jseyfert3/Indoor-Outdoor_Temp_Sensor/Documentation/Documentation.odt

Indoor-Outdoor Temp Sensor

Documentation, Rev 1.0

## Usage

Indoor sensor

The indoor sensor has a LCD display and three buttons in the front panel of the enclosure. On the right hand side of the enclosure is an opening that allows plugging a microUSB cable in. This will power the indoor sensor. The microcontroller PCB contains a single cell lithium battery charger circuit and JST-PH battery connector. If desired, a single-cell lithium battery may be connected to the PCB. If connected, this will power the microcontroller, sensor, and LCD display if USB is not connected, and will automatically recharge when the USB is connected. The microcontroller code for the indoor sensor has not been optimized for power consumption, so a large battery or a change to the code is suggested if battery operation is desired.

The enclosure is 3D printed with PLA plastic. The rear of the enclosure contains three standard screw mounting holes, for wall hanging with 1 or 2 screws/nails. The bottom of the enclosure contains vent holes next to the temp/humidity sensor. For proper indoor air sensing, the enclosure should not be set on a flat surface.

To use, plug in a microUSB cable connected to a 5 V USB power supply or computer. The device will power up automatically. A red light near the USB connector will light up and begin fading in and out. This indicates the microcontroller is running and is not stuck or frozen. A green LED will be visible near the bottom of the case. This is a power indicator on the SHT45 temp/humidity sensor breakout board, indicating the sensor has power.

Upon power-up, the LCD display will light up and begin displaying data within a few seconds. If an error is detected, an error message will be displayed as the first data screen. These errors include:

- “Unable to initialize SHT45!” – if temp/humidity sensor cannot be communicated with
- “Unable to initialize RTC!” – if the real-time clock cannot be communicated with
- “Unable to initialize SD card!” – if the SD card cannot be communicated with (no SD card, not properly inserted, improperly formatted, etc)

If no errors are detected, the first data screen will be the main display screen of the unit. Indoor data should populate immediately, but outdoor data will not populate until the first transmission from the outdoor unit has been received. Until then, the outdoor data will display as “0.0”

In the upper left corner of the screen is a section titled “Last update:” Below this is “I-” and “O-” followed by a time in 24-hr format. This indicates the times, based on the RTC, at which the indoor and outdoor data was last updated. This is particularly useful for determining if the outdoor sensor has stopped updating, as the outdoor time will stop advancing if no new data is received. It’s typical for the outdoor time to be 1 minute behind the indoor time, as the outdoor unit only sends new data every ~16 seconds, but more than 1 minute indicates a potential failure of the outdoor unit, or interference in the radio transmission or reception.

Configuration and Alternate Displays

From the main display screen, pressing the left button will have the display switch to an alternate sensor. Currently, the display says “Keg” as during coding I had a sensor installed in my kegerator to monitor humidity and temp inside the kegerator. With the addition of another set of hardware similar to the outdoor sensor, an additional sensor can be added to measure the temp/humidity in any desired location, e.g. the basement. Without an additional sensor(s), the screen will just display 0’s. After 10 seconds, the display will revert to the main indoor/outdoor display.

Pressing the right button from the main display screen will display the min/max temp for both indoor and outdoor temps. The min/max time will be since the microcontroller last restarted, either by power cycling or pressing the reset button or updating the firmware. The date/time since last reset is displayed in small text above the min/max temps. After 10 seconds, the display will revert to the main indoor/outdoor display.

Pressing the middle button from the main display screen will open the Configuration Menu. Within the configuration menu, the left key is down, the right key is up, and the middle is select/exit. Use the up and down keys to select a menu option (currently only LCD brightness does anything), and select to enter. Use the up and down keys to adjust the setting and short press select to set and exit back to the top menu. Long press select to exit the Configuration Menu.

Data Logging

Outdoor sensor

The outdoor sensor consists of a 3D printed Stevenson screen and associated mounting brackets. These are printed out of ASA plastic for UV resistance. The base of the screen contains a mounting bracket that holds the microcontroller, temp/humidity sensor, and a battery.

## Hardware Overview

The indoor sensor contains:

- 1.9” Color IPS TFT display (Adafruit 5394)
  - Contains a microSD card slot, which is not used
- Microcontroller, Cortex M0-based with RFM69HCW packet radio, 915 MHz (Adafruit 3176)
  - Spring antenna (Adafruit 4269)
- FeatherWing with PCF8523 RTC & microSD card slot (Adafruit 2922)
  - 8 GB microSD card (Adafruit 1294)
  - CR1220, 3V lithium coin cell for RTC
- Sensirion SHT45 temperature and humidity sensor (Adafruit 5665)
  - JST SH 4-pin to male header cable (Adafruit 4209 or equivalent)
- MicroUSB cable (Adafruit 592)
- 3D printed case

The outdoor sensor contains:

- Microcontroller, Cortex M0-based with RFM69HCW packet radio, 915 MHz (Adafruit 3176)
- Battery, single-cell 2200 mAh lithium with JST-PH connector
- Sensirion SHT45 temperature and humidity sensor (Adafruit 5665)
  - JST SH 4-pin to male header cable (Adafruit 4209 or equivalent)
- 3D printed enclosure
  - Stevenson screen (https://www.thingiverse.com/thing:4153206)
  - Stevenson screen base, custom modification of the one in above link
  - Stevenson screen base mounting bracket
  - Sensor/battery/microcontroller mount
