jseyfert3/Indoor-Outdoor_Temp_Sensor/Documentation/Adafruit/bq24074 schematic.png

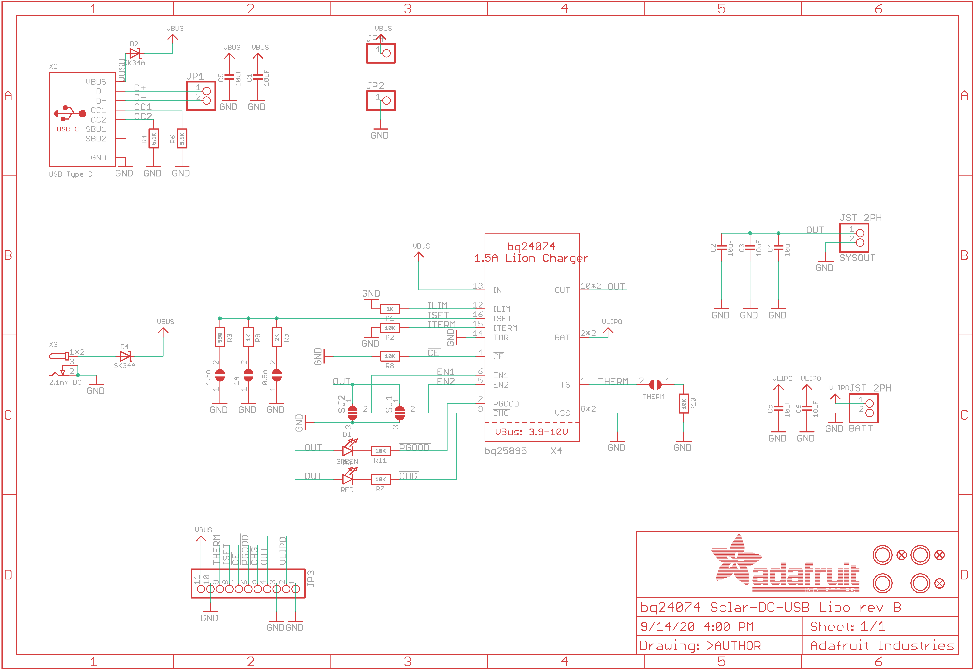
Documentation/Adafruit/bq24074 schematic.png
