jseyfert3/Indoor-Outdoor_Temp_Sensor/Documentation/Adafruit/RFM69 M0 pinout.jpg

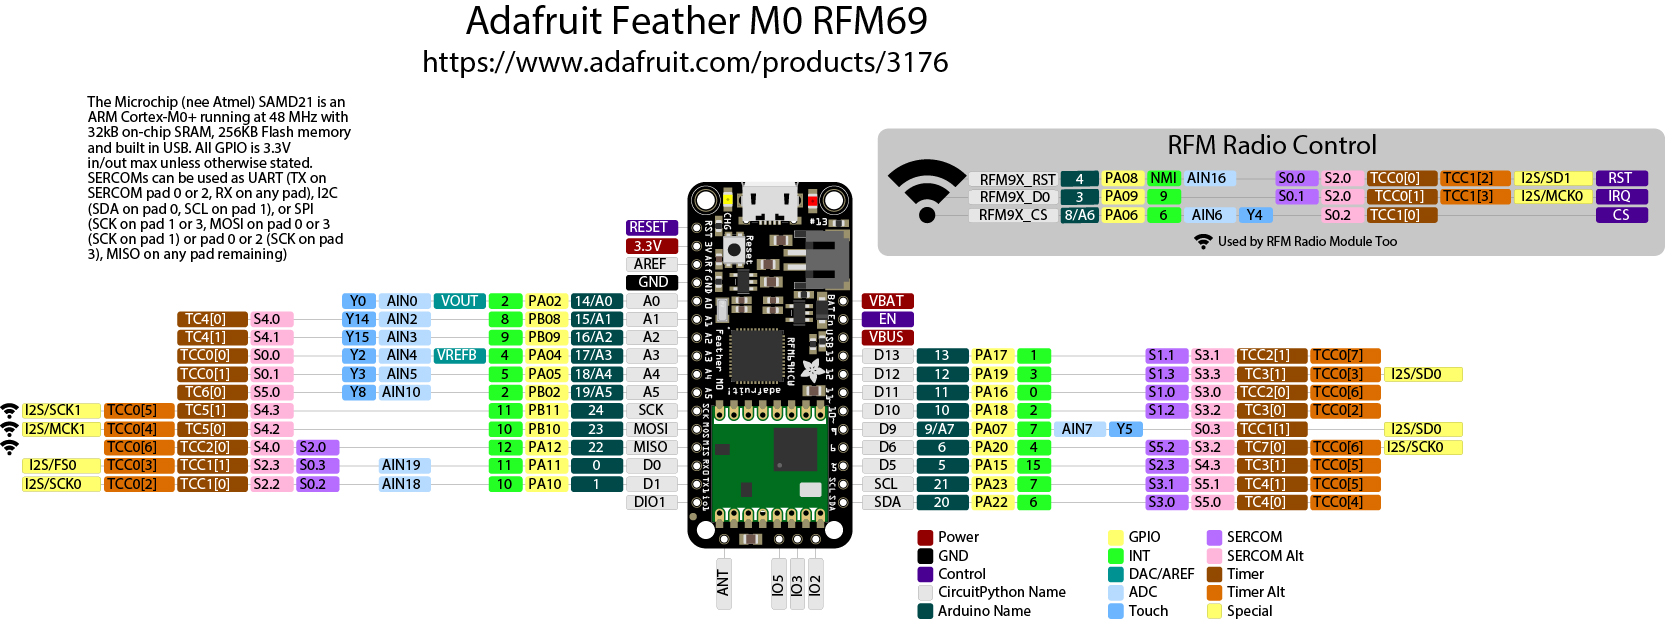
Documentation/Adafruit/RFM69 M0 pinout.jpg
