jseyfert3/Indoor-Outdoor_Temp_Sensor/Documentation/Adafruit/SHT40 schematic.png

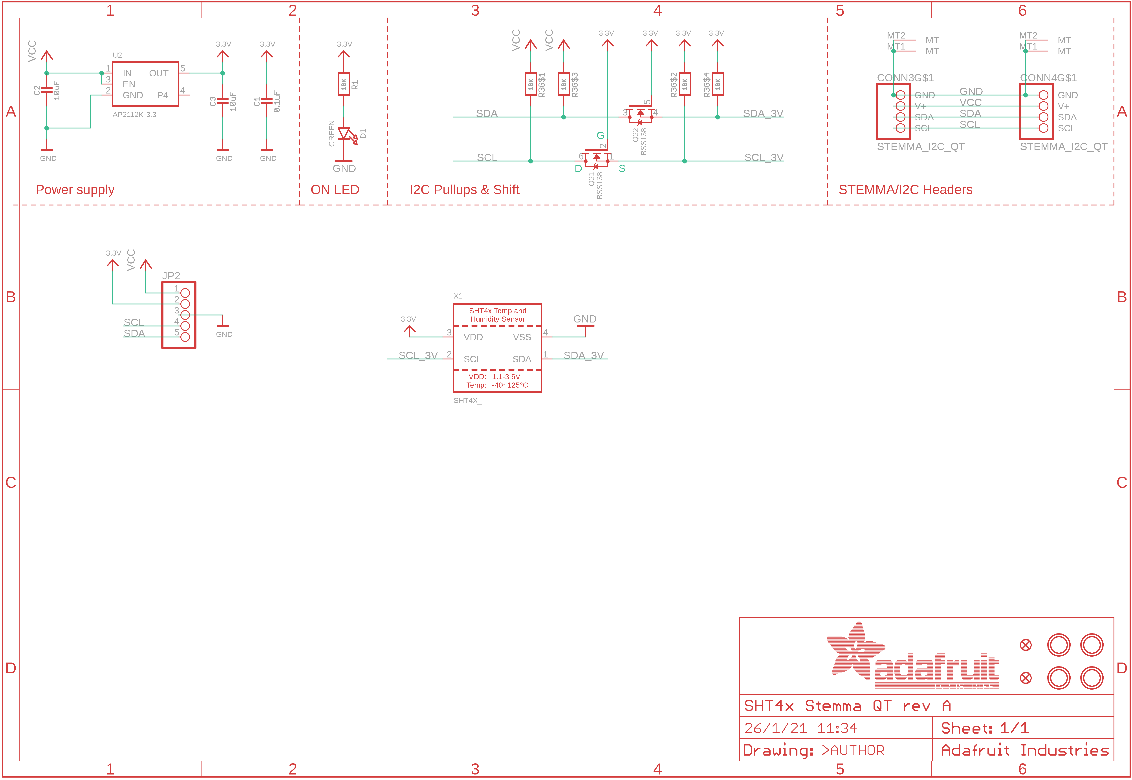
Documentation/Adafruit/SHT40 schematic.png
