jseyfert3/Indoor-Outdoor_Temp_Sensor/3D Models/Case Body.FCStd

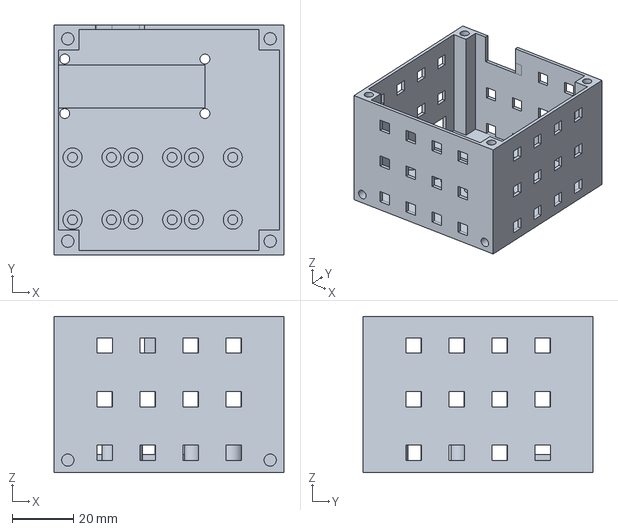
[picture p4: CAD file, 2025-06-13]
3D Models/Case Body.FCStd
75.0 x 75.0 x 51.0 mm
