jseyfert3/Indoor-Outdoor_Temp_Sensor/3D Models/Front case-Body.step

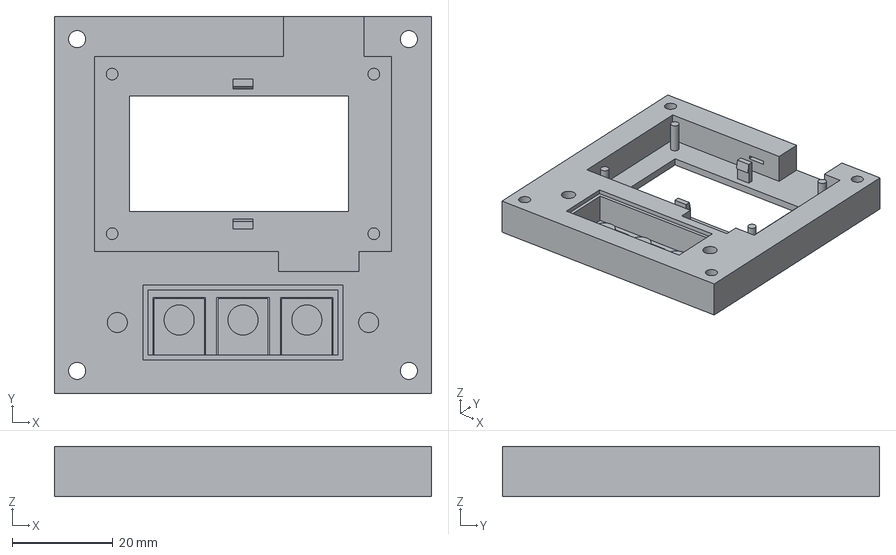
[picture p5: CAD file, 2025-06-08]
3D Models/Front case-Body.step
75.0 x 75.0 x 10.0 mm
