jseyfert3/Indoor-Outdoor_Temp_Sensor/3D Models/Switch bracket.FCStd

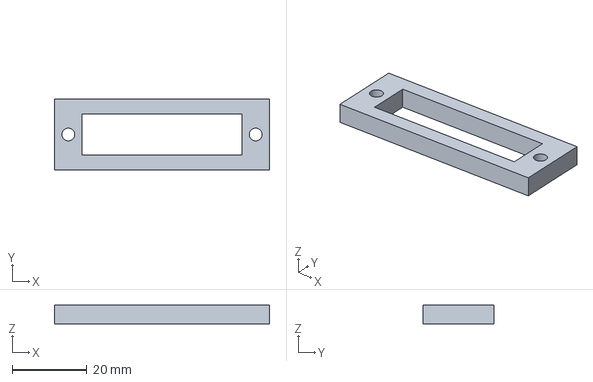
[picture p7: CAD file, 2025-01-25]
3D Models/Switch bracket.FCStd
57.4 x 19.0 x 5.00 mm
