jseyfert3/Indoor-Outdoor_Temp_Sensor/3D Models/Stevensen Base - Custom.FCStd

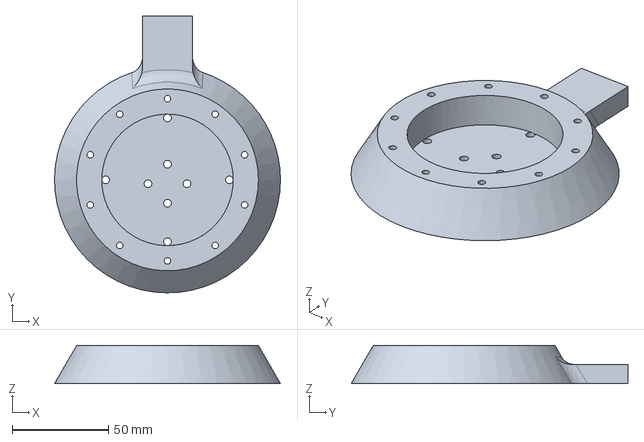
[picture p8: CAD file, 2025-01-25]
3D Models/Stevensen Base - Custom.FCStd
117.6 x 144.0 x 19.9 mm
