jseyfert3/Indoor-Outdoor_Temp_Sensor/3D Models/mounting bracket.FCStd

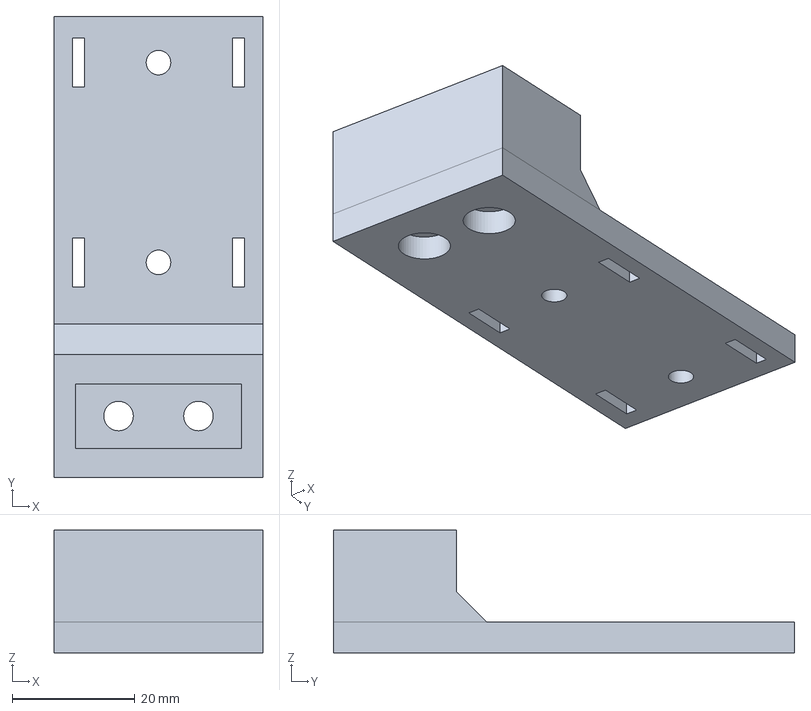
[picture p9: CAD file, 2025-01-25]
3D Models/mounting bracket.FCStd
34.0 x 75.0 x 20.0 mm
