jseyfert3/Indoor-Outdoor_Temp_Sensor/3D Models/PCB locking braket.FCStd

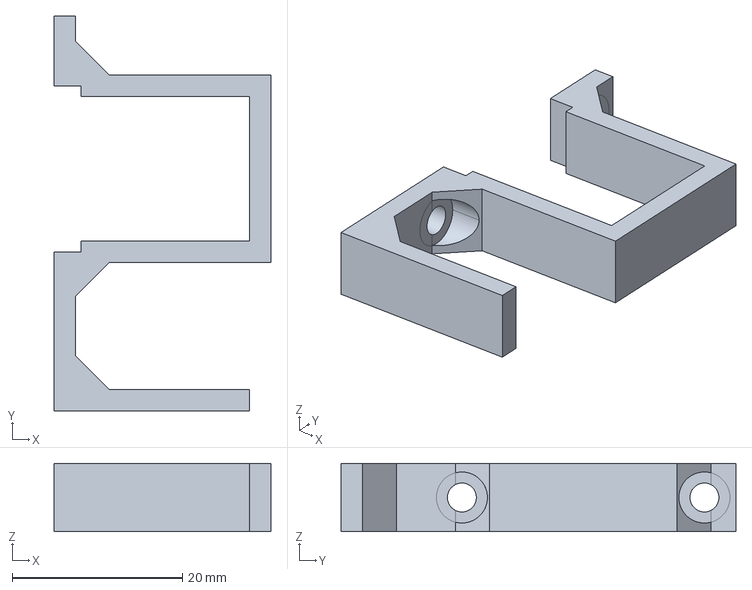
[picture p10: CAD file, 2025-01-25]
3D Models/PCB locking braket.FCStd
25.5 x 46.4 x 8.00 mm
