jseyfert3/Indoor-Outdoor_Temp_Sensor/3D Models/sensor_mount-Body.step

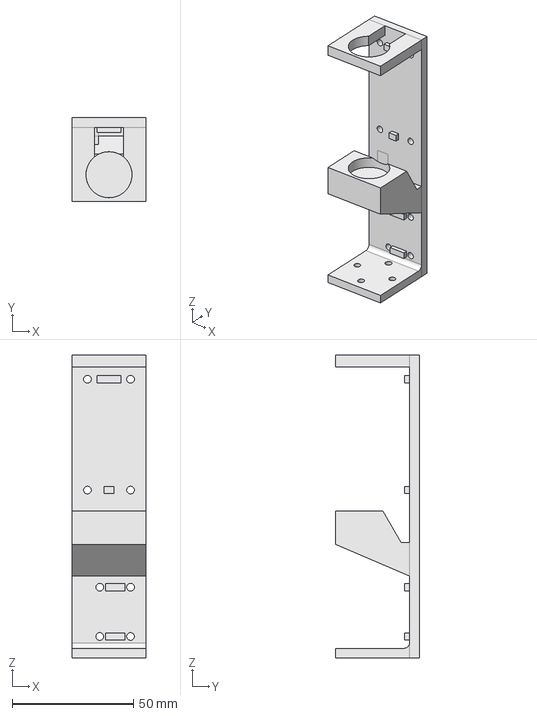
[picture p11: CAD file, 2025-01-25]
3D Models/sensor_mount-Body.step
30.5 x 34.5 x 125.0 mm
