jseyfert3/Indoor-Outdoor_Temp_Sensor/(list of files, cad)

Other CAD files:
3D Models/Case Body-Body.step
3D Models/Front case.FCStd
3D Models/Switch bracket-Body.step
3D Models/PCB locking braket-Body.step
3D Models/sensor_mount.FCStd
3D Models/mounting bracket-Body.step
