jseyfert3/Indoor-Outdoor_Temp_Sensor/Documentation/Adafruit/adafruit_products_SHT40_fab_print.png

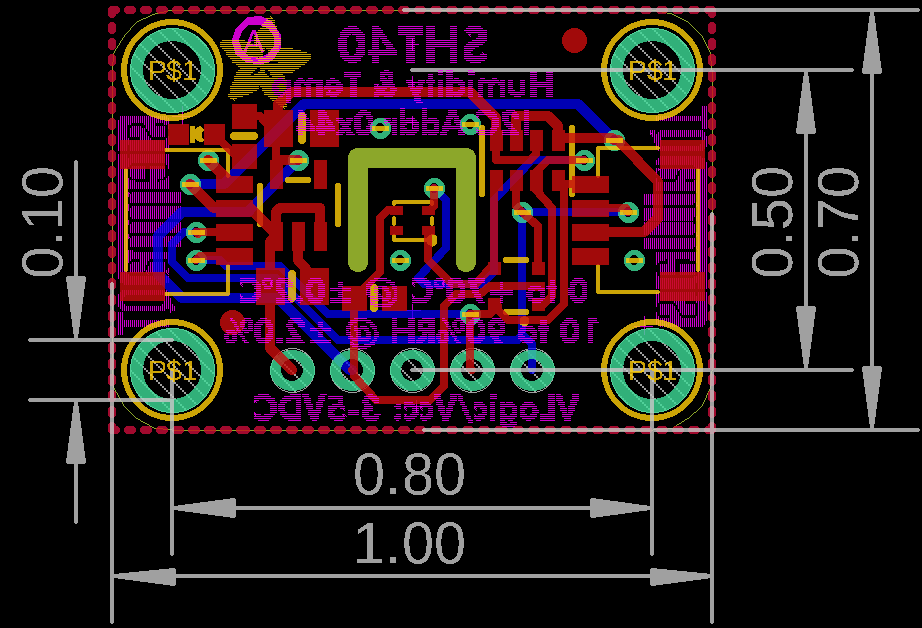
Documentation/Adafruit/adafruit_products_SHT40_fab_print.png
