jseyfert3/Indoor-Outdoor_Temp_Sensor/Documentation/Adafruit/Fab print of LCD.png

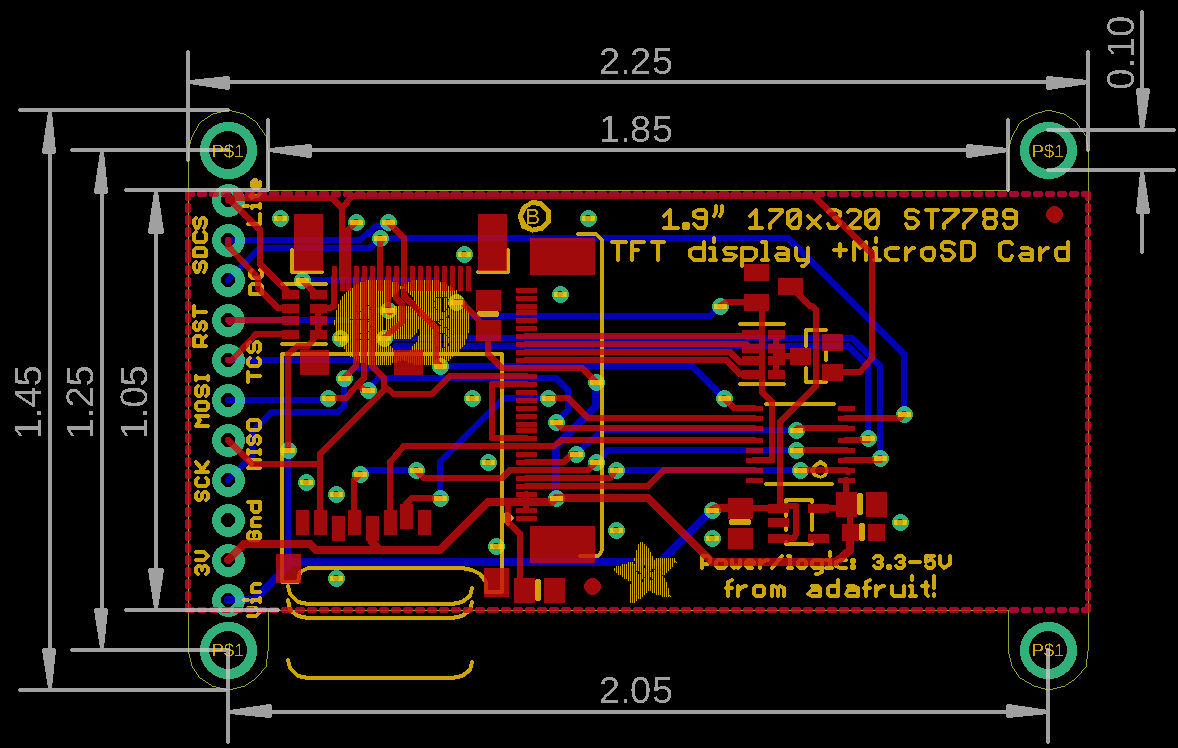
Documentation/Adafruit/Fab print of LCD.png
