jseyfert3/Indoor-Outdoor_Temp_Sensor/Documentation/Adafruit/sensors_BMP390_fab_print.png

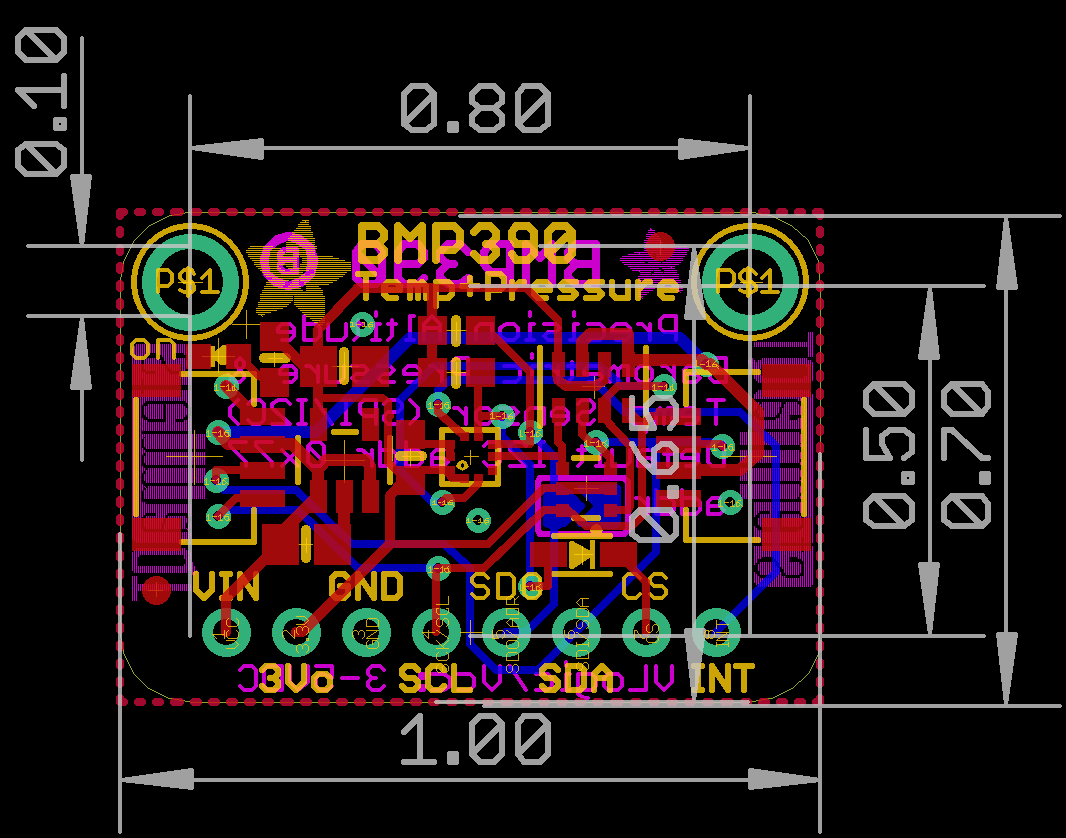
Documentation/Adafruit/sensors_BMP390_fab_print.png
