jseyfert3/Indoor-Outdoor_Temp_Sensor/Documentation/Outdoor_Schematic/Outdoor_Schematic.kicad_pcb

## KiCad design board/teensyCan/teensyCan.kicad_sch

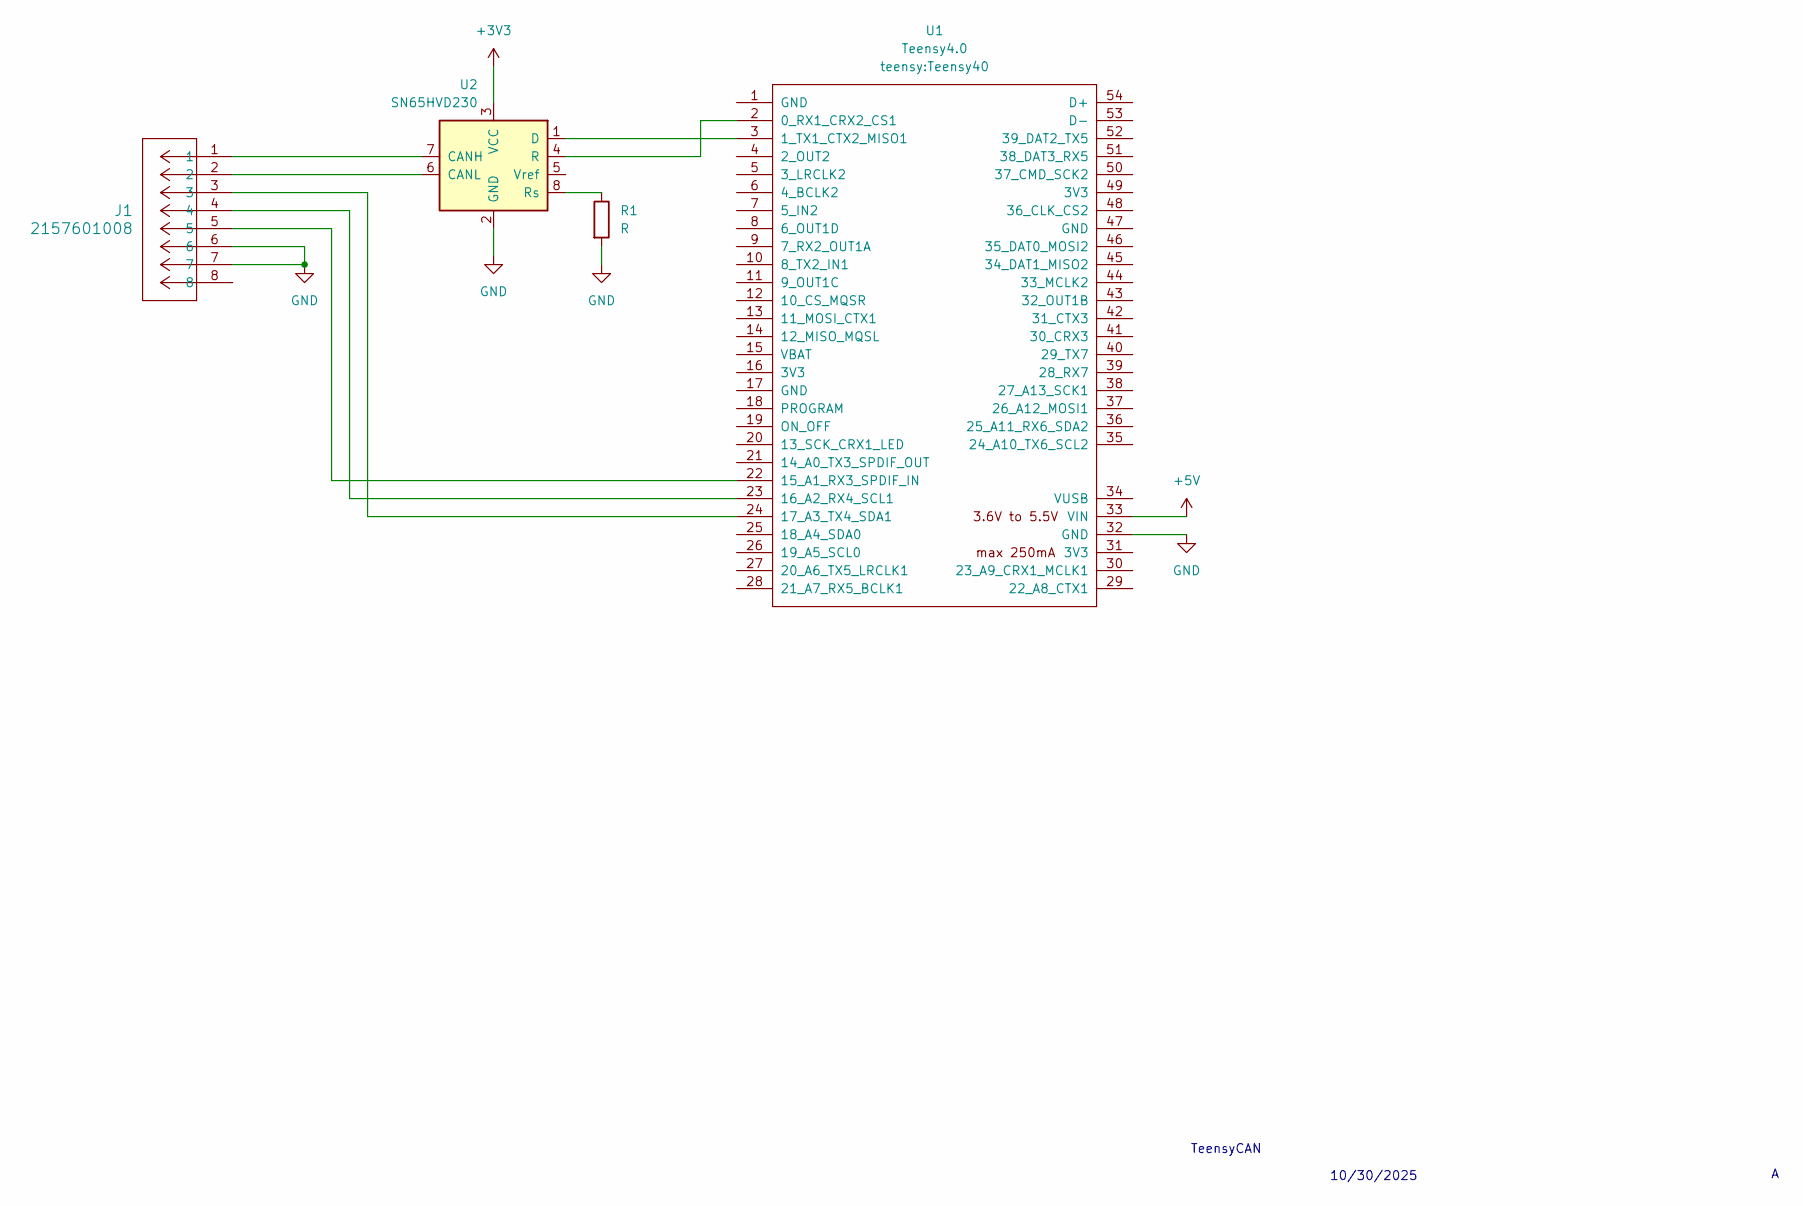
[picture p15: schematic teensyCan.kicad_sch]

Parts:
J1: 2157601008; CONN08_2157601008_MOL
R1: R; R_1206_3216Metric_Pad1.30x1.75mm_HandSolder
U1: Teensy4.0; Teensy40
U2: SN65HVD230; SOIC-8_3.9x4.9mm_P1.27mm

Connections:
+3V3: U2.3 (VCC)
+5V: U1.33 (VIN)
GND: J1.6, J1.7, R1.2, U1.32 (GND), U2.2 (GND)
unnamed: J1.1, U2.7 (CANH)
unnamed: J1.2, U2.6 (CANL)
unnamed: J1.3, U1.24 (17_A3_TX4_SDA1)
unnamed: J1.4, U1.23 (16_A2_RX4_SCL1)
unnamed: J1.5, U1.22 (15_A1_RX3_SPDIF_IN)
unnamed: R1.1, U2.8 (Rs)
unnamed: U1.2 (0_RX1_CRX2_CS1), U2.4 (R)
unnamed: U1.3 (1_TX1_CTX2_MISO1), U2.1 (D)

Notes on the sheet:
10/30/2025
TeensyCAN
