jseyfert3/Indoor-Outdoor_Temp_Sensor/(commit log)

2025-01-25 Initial public release v.1.0.0
    [Case Body-Body.step, Case Body.FCStd, Front case-Body.step, Front case.FCStd, PCB locking braket-Body.step, PCB locking braket.FCStd, Stevensen Base - Custom-Body.step, Stevensen Base - Custom.FCStd]
2025-06-07 fix: Selecting "Other setting" in menu will get stuck in menu and requires reboot.
    [Indoor_Temp_Sensor.ino]
2025-06-08 feat: Case front mod, initial schematics
    Front case has been modified to have a cutout for accessing the microSD card from LCD without removing cover. A second cutout was added to give strain relief to the ribbon cable, which is now being used.
    KiCad schematics have been added for the indoor section of the project, though there are several things where the schematics are advanced of the code:
    1) The code for the indoor sensor expects a PCF8523 RTC + microSD FeatherWing (Adafruit 2922), not the DS3231 Precision RTC Featherwing (Adafruit 3028) shown.
    2) The LCD (Adafruit 5394) is not shown. It connects with a 18 wire ribbon cable to the EYESPI breakout board.
    3) The code expects to use the m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
    [Front case-Body.step, Front case.FCStd, Indoor_Schematic.kicad_pcb]
2025-06-13 feat: Case & documentation update
    Case has been updated with new screw-in design to hold Feather and reduce size of case. Numerous ventilation holes were also added, to support multiple small form factor boards (SHT45, BMP310, etc).
    Added fab prints of a few boards for reference.
    [Case Body-Body.step, Case Body.FCStd]
2025-06-14 feat: Outdoor schematic, documentation
    Added schematic for outdoor unit, including solar panel and solar charger that isn't yet part of the code. This is in preparation for the AQI sensor and any other sensors that will require more power than the SHT45 does.
    Documentation additions are just to try to get everything documented for this project.
    [Outdoor_Schematic.kicad_pcb]
2025-06-15 feat: Switched to using RHReliableDatagram
    Changed from the basic RH69 message sending and receiving to the RHReliableDatagram based method. This class has ack for sent messages and auto-repeat transmittion if it doesn't receive an ack.
    Currently just uses the default number of retries on failed ack of 3.
    In the future, could use number of transmission re-tries to vary power level, or change transmit frequency, etc. Currently just light the LED on remote sensor red if it fails the 3 retransmits and doesn't get an ack.
    [Indoor_Temp_Sensor.ino, Outdoor_Temp_Sensor.ino]
2025-06-15 refact: Outdoor code works any length message
    Refactored prior code to allow outdoor unit to send arbitrary numbers of packets for arbitrary lengths of json code. Still need to add in message x of y into packets, but should be fairly easy to do with framework that exists now.
2025-06-15 feat: Indoor unit rx parsing to JSON
    Now parses the received multi-packet messages to JSON. There's a key called "units" with an array of key-value pairs, each unit will save to it's designated unit in the JSON.
    TODO:
    *Update code to save indoor measurements to JSON
    *Update functions to use JSON instead of existing variables
    *Update functions to allow several remote temp/humidity sensors
2025-06-18 fix: SHT45 read failures after sleep
    For a long time the SHT45 has has random failures to get event. Originally I thought this was corrosion on the micro and just added a loop to try again up to 10 times. But a new micro was used and had the same problem. Eventually I figured out I just needed to do a new begin() after it came out of sleep and then it stopped having issues.
    To be clear, this wasn't because the micro went to sleep, but because I shut the power to the SHT45 off during sleep to save power. The power back on of the SHT45 is what had random issues with comms afterwards.
    [Outdoor_Temp_Sensor.ino]
2025-06-22 refect: Indoor unit json updates, formatting
    * Formatted code to use tabs, expecting tab stops every 4 columns.
    * Added feature parity with code prior to JSON update, EXCEPT THAT IT NOW SAVES A JSON STRING instead of a csv
    * Updated to fixed width variables
    * Probably some other stuff I forgot
    [Indoor_Temp_Sensor.ino, Outdoor_Temp_Sensor.ino]
