jseyfert3/Indoor-Outdoor_Temp_Sensor/(notices)

Notices in the files:
Indoor_Temp_Sensor/Indoor_Temp_Sensor.ino:
Indoor-Outdoor_Temp_Sensor is free software: you can redistribute it and/or modify it under the terms of the GNU General Public License
